uncle-lu/timeClock/README.md

# 电子设计实习-数字钟

基于74LS160实现的数字钟

## 功能

- 1Hz计数
- 时分秒显示
- 快捷校时
- 整点报时

## 组件

- 555组成多谐振荡器
- 74LS160组成分频器
- 74LS160组成60进制计数器
- 74LS160组成24进制计数器
- 报时电路
- 校时电路

## 集成电路器件

- 555
- 74LS160
- 74LC4511
- 74LS00
- 74LS20
- 74LS02
