uncle-lu/timeClock/doc/img/运行图像.png

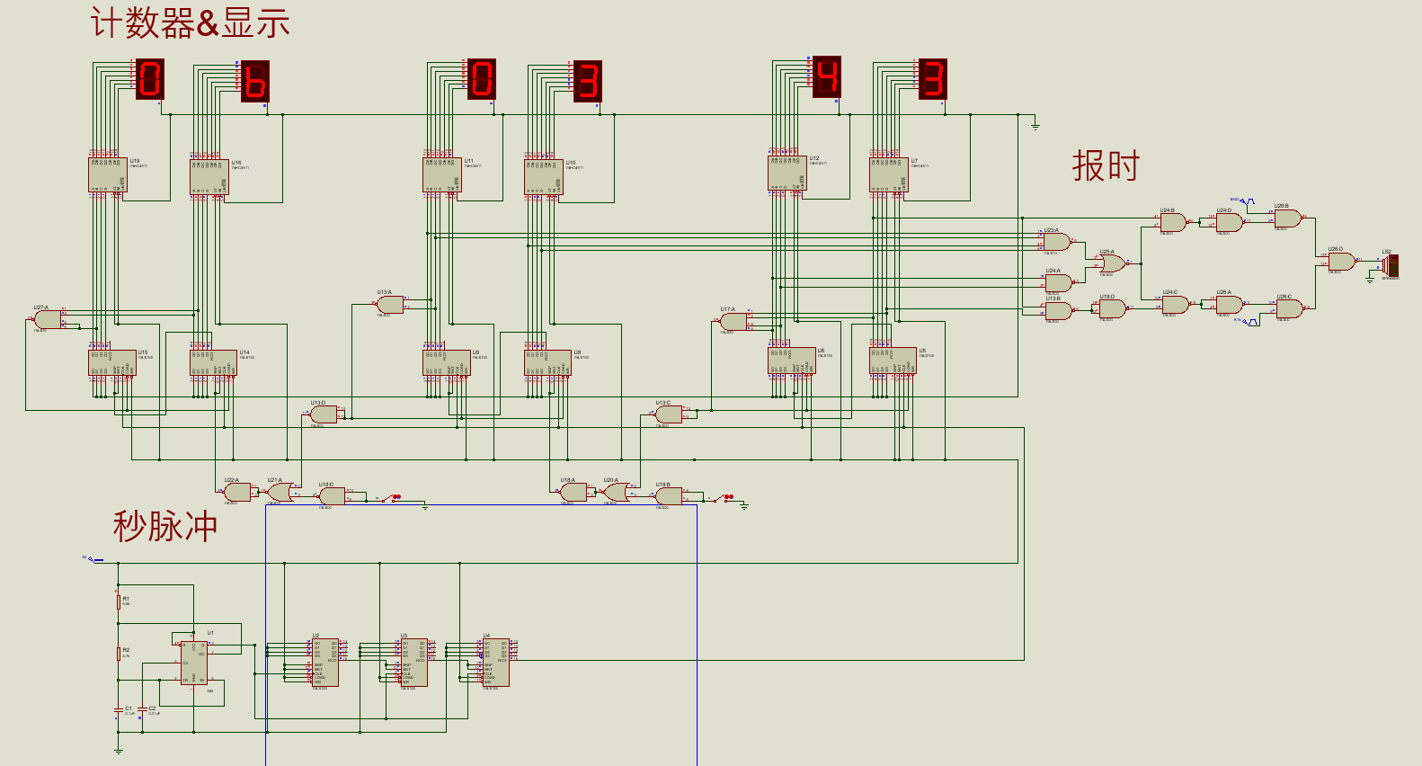
doc/img/运行图像.png
