uncle-lu/timeClock/test/speak.PDF

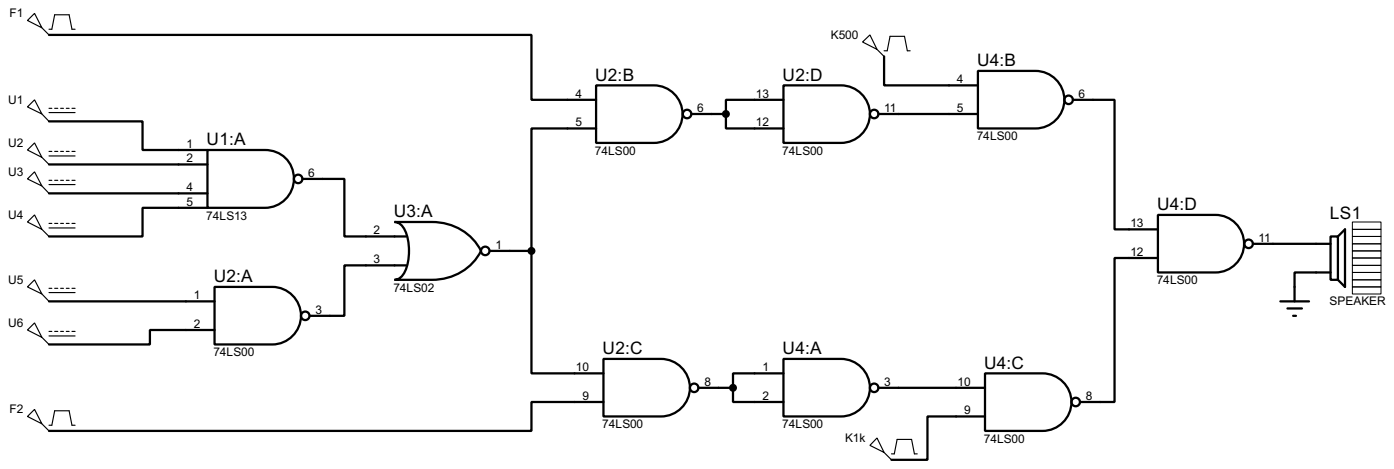
[picture p8: page 1]
