uncle-lu/timeClock/doc/pdf/总电路.PDF

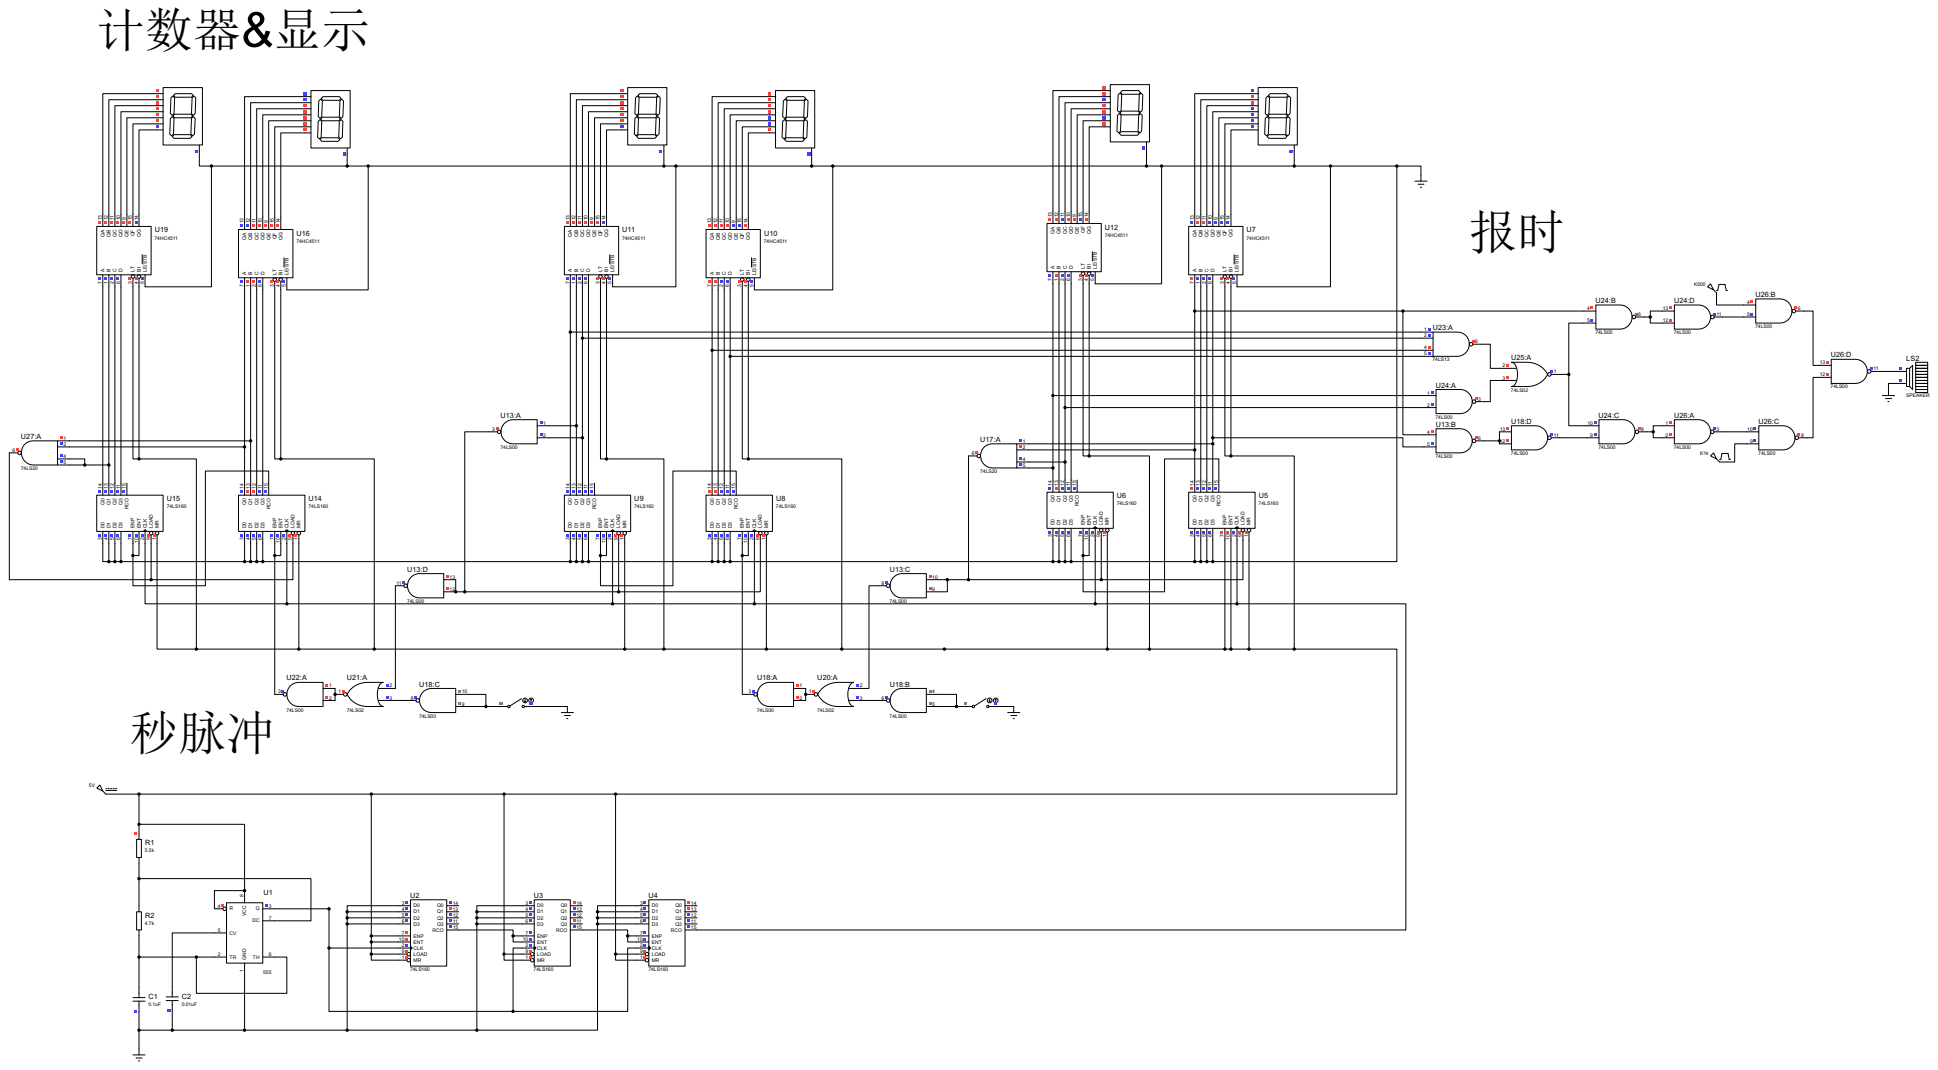
[picture p9: page 1]
