uncle-lu/timeClock/doc/pdf/报时电路.PDF

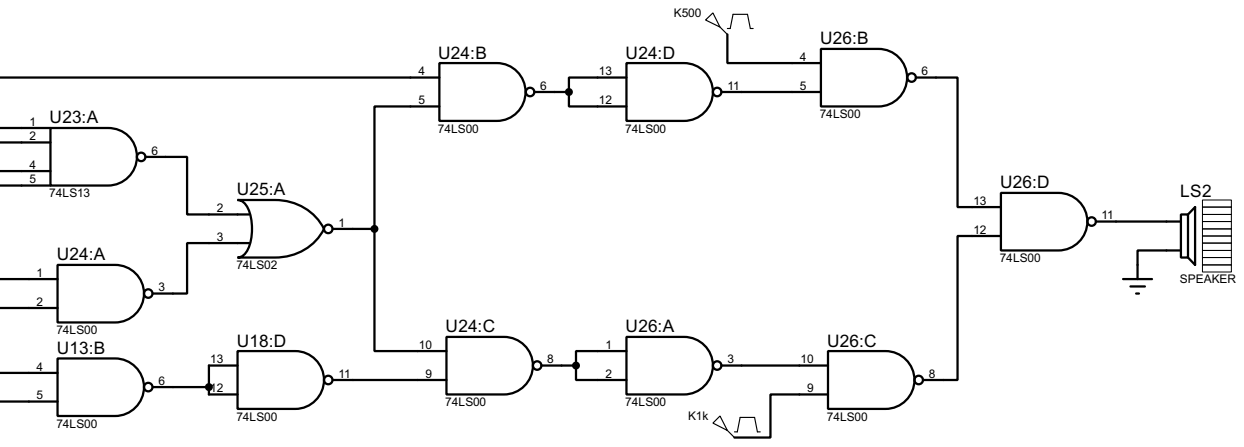
[picture p10: page 1]
