uncle-lu/timeClock/doc/pdf/秒脉冲.PDF

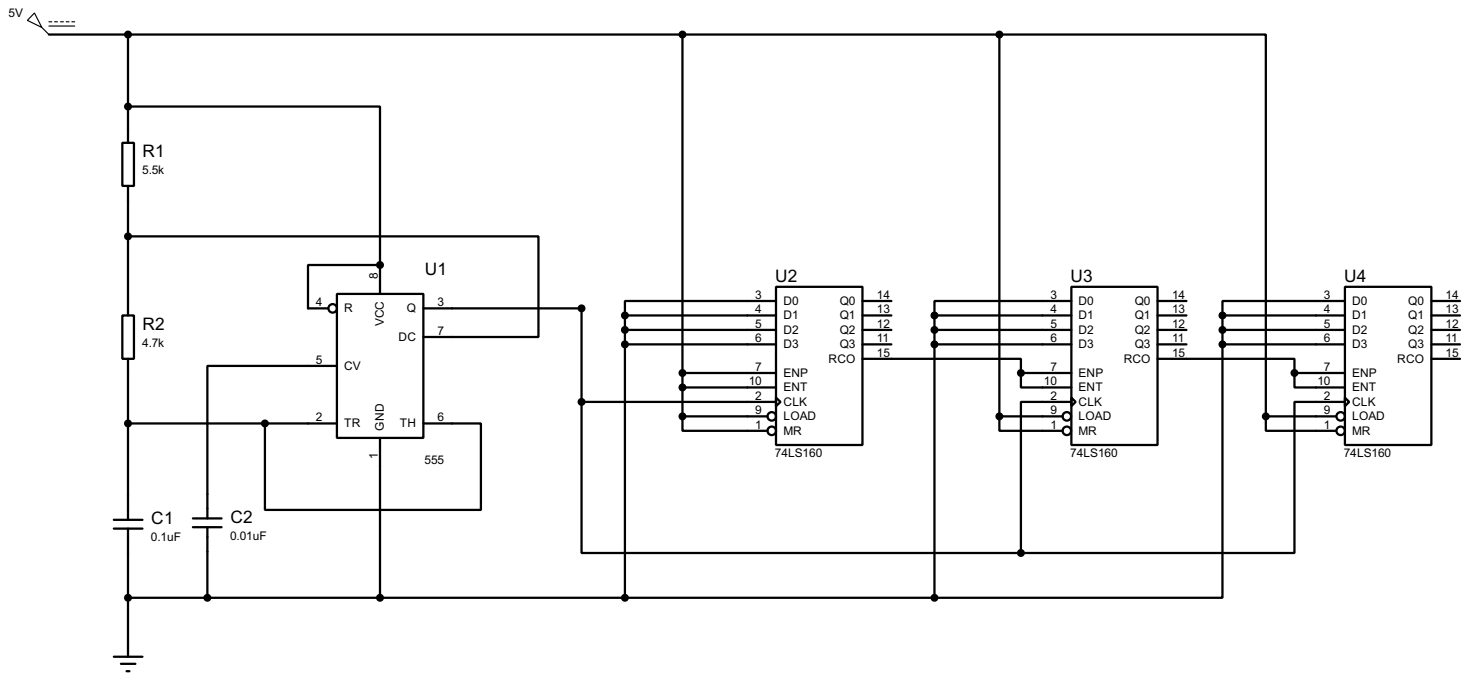
[picture p11: page 1]
