uncle-lu/timeClock/doc/pdf/自动校时电路.PDF

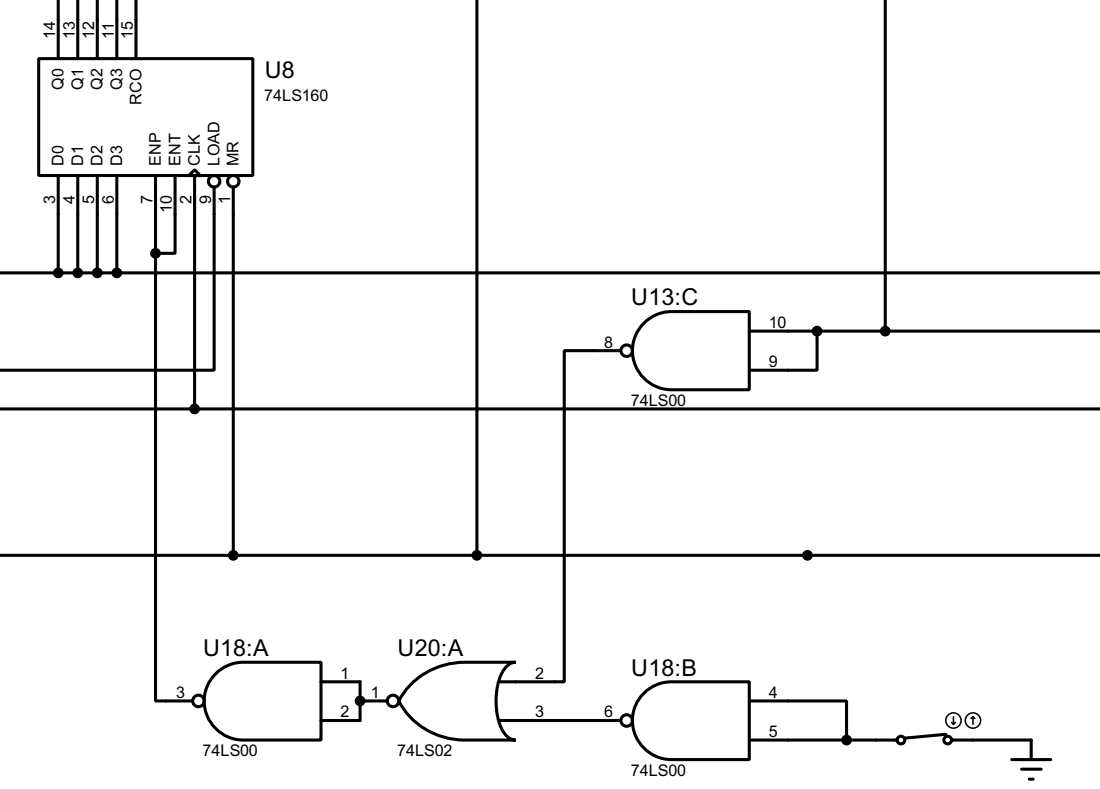
[picture p12: page 1]
