uncle-lu/timeClock/doc/pdf/计数器-24进制.PDF

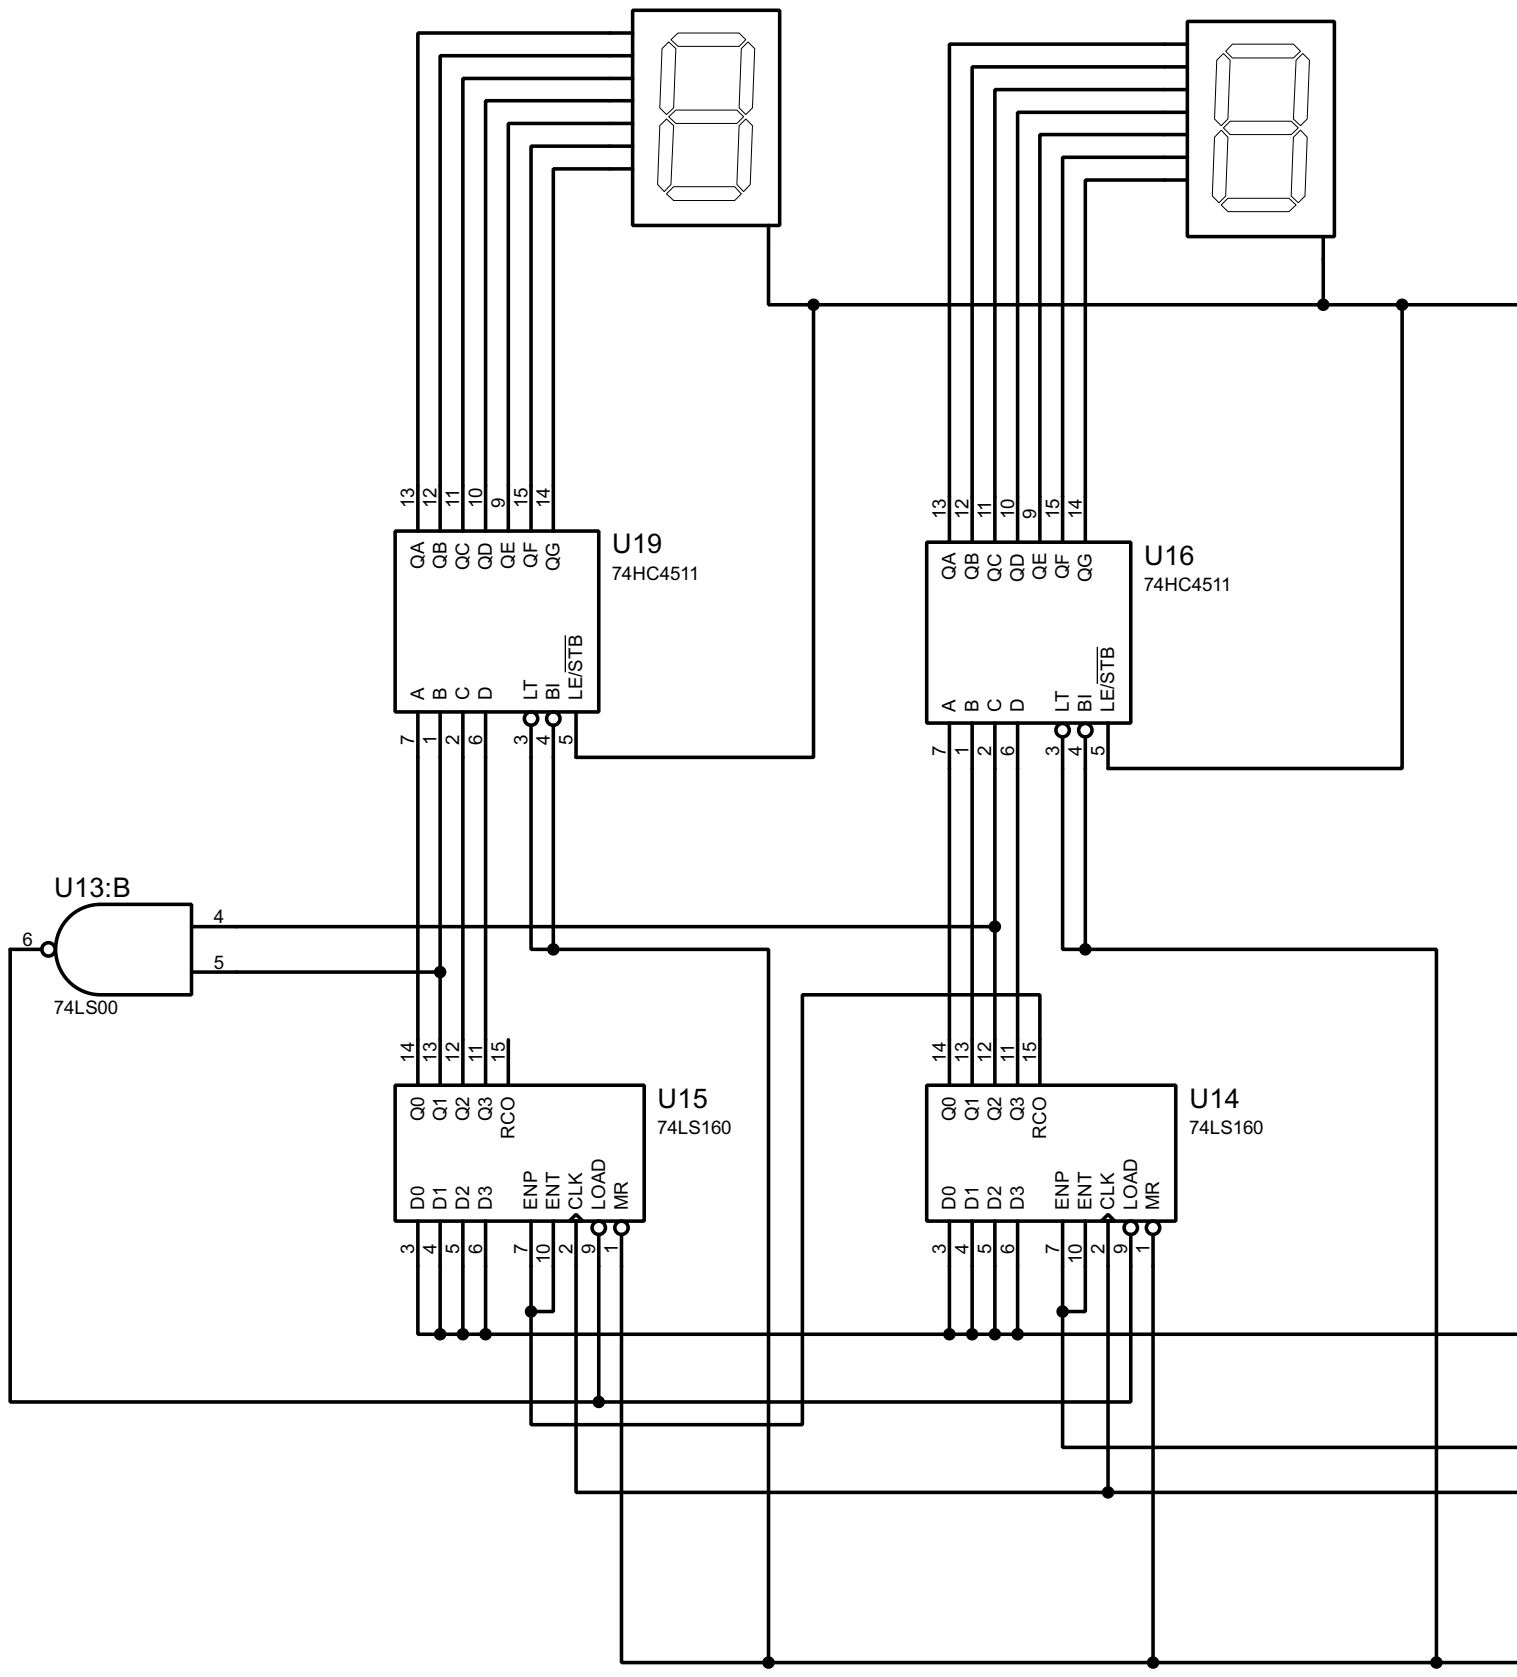
[picture p13: page 1]
