uncle-lu/timeClock/doc/pdf/计数器-60进制.PDF

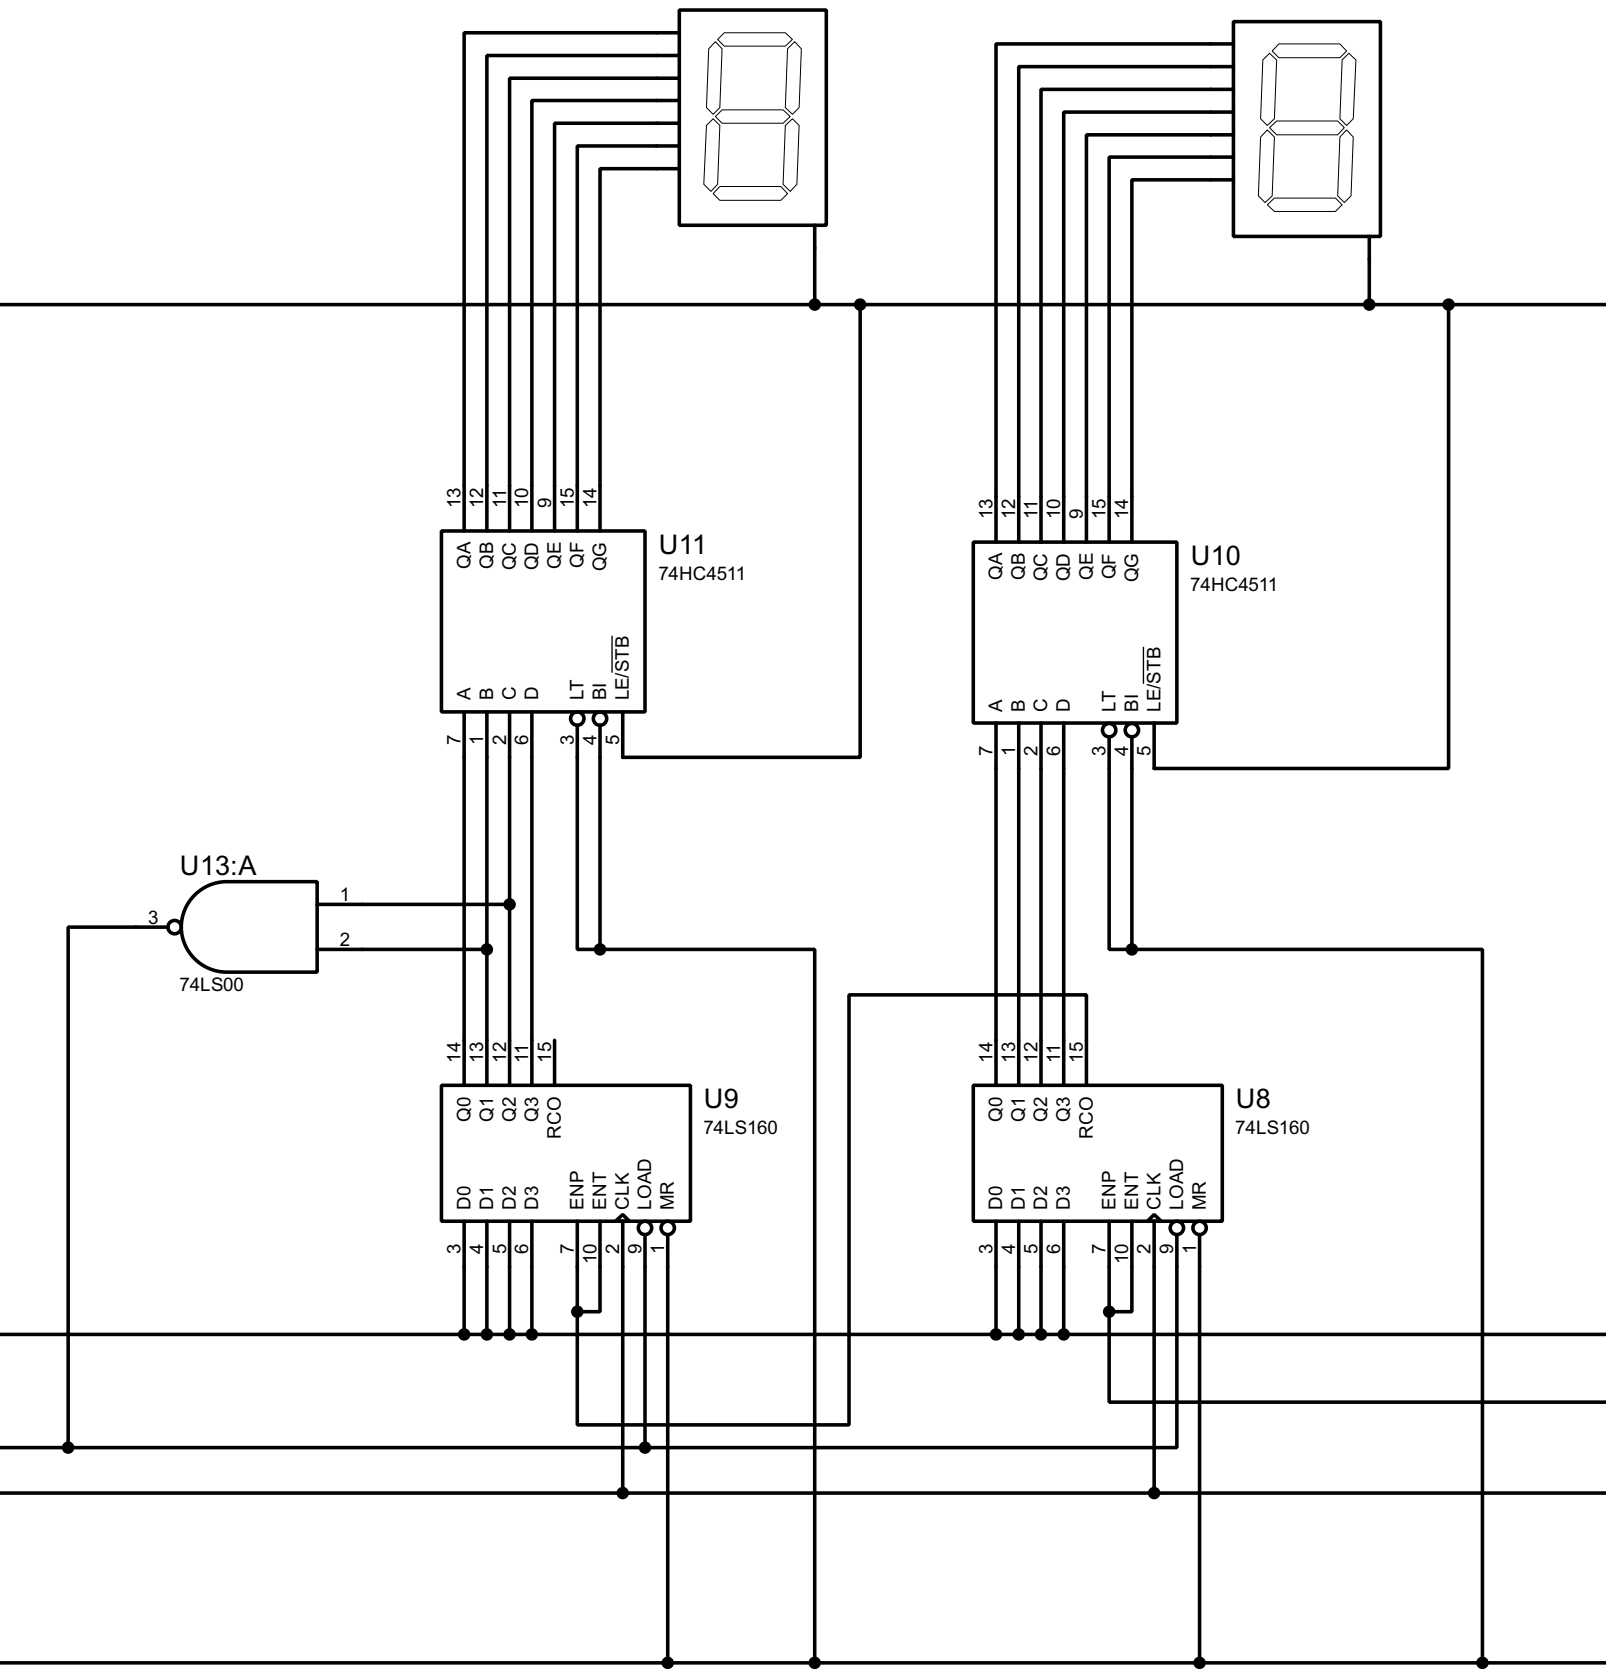
[picture p14: page 1]
