uncle-lu/timeClock/doc/pdf/计数器-全.PDF

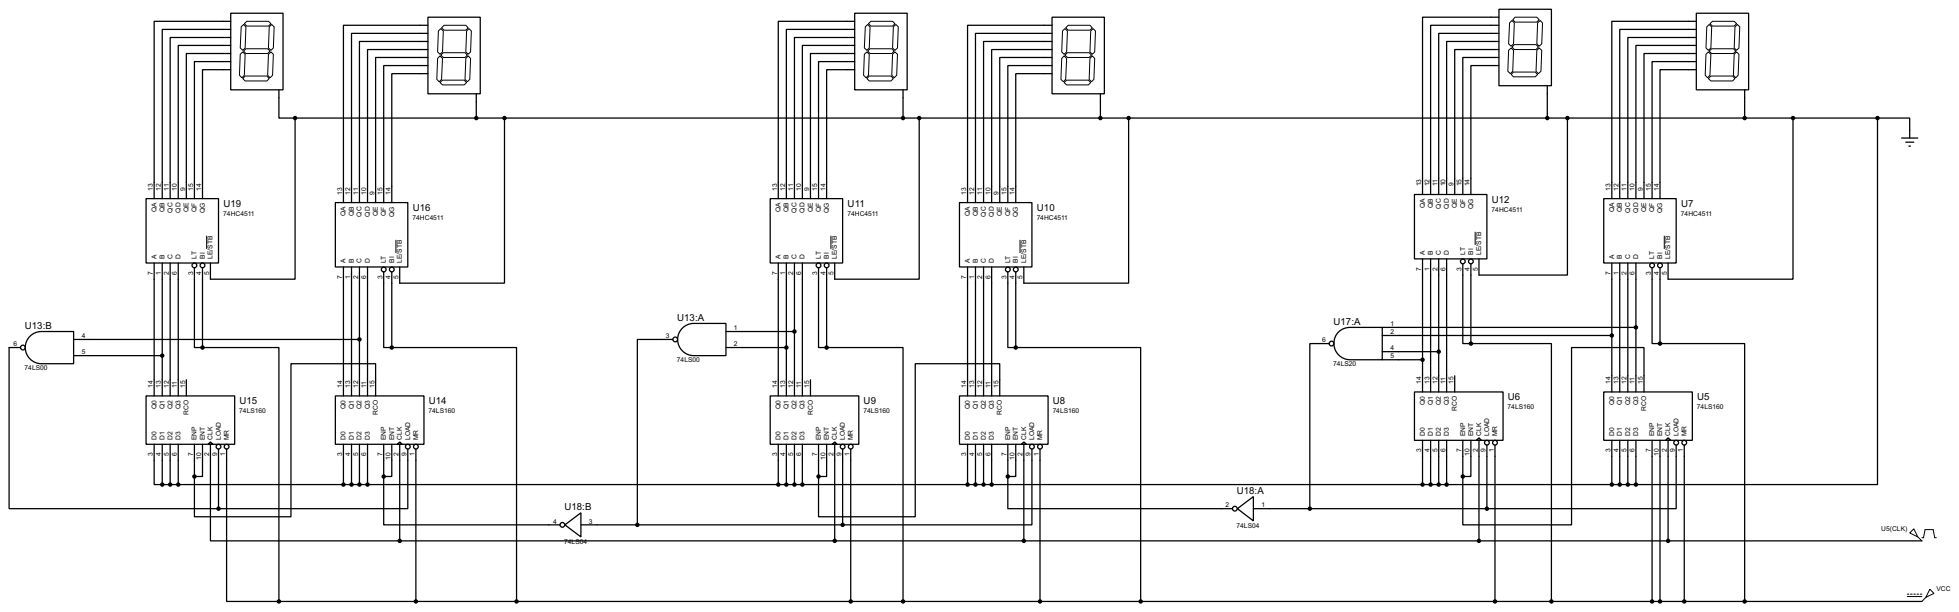
[picture p15: page 1]

D0 3 Q0 14 D1 4 Q1 13 D2 5 Q2 12 D3 6 Q3 11 RCO 15 ENP 7 ENT 10 CLK 2 LOAD 9 MR 1 U5 74LS160 D0 3 Q0 14 D1 4 Q1 13 D2 5 Q2 12 D3 6 Q3 11 RCO 15 ENP 7 ENT 10 CLK 2 LOAD 9 MR 1 U6 74LS160 A 7 B 1 C 2 D 6 LT 3 BI 4 LE/STB 5 QA 13 QB 12 QC 11 QD 10 QE 9 QF 15 QG 14 U7 74HC4511 A 7 B 1 C 2 D 6 LT 3 BI 4 LE/STB 5 QA 13 QB 12 QC 11 QD 10 QE 9 QF 15 QG 14 U12 74HC4511 VCC 2 1 U18:A 74LS04 1245 6 U17:A 74LS20 D0 3 Q0 14 D1 4 Q1 13 D2 5 Q2 12 D3 6 Q3 11 RCO 15 ENP 7 ENT 10 CLK 2 LOAD 9 MR 1 U8 74LS160 D0 3 Q0 14 D1 4 Q1 13 D2 5 Q2 12 D3 6 Q3 11 RCO 15 ENP 7 ENT 10 CLK 2 LOAD 9 MR 1 U9 74LS160 A 7 B 1 C 2 D 6 LT 3 BI 4 LE/STB 5 QA 13 QB 12 QC 11 QD 10 QE 9 QF 15 QG 14 U10 74HC4511 A 7 B 1 C 2 D 6 LT 3 BI 4 LE/STB 5 QA 13 QB 12 QC 11 QD 10 QE 9 QF 15 QG 14 U11 74HC4511 D0 3 Q0 14 D1 4 Q1 13 D2 5 Q2 12 D3 6 Q3 11 RCO 15 ENP 7 ENT 10 CLK 2 LOAD 9 MR 1 U14 74LS160 D0 3 Q0 14 D1 4 Q1 13 D2 5 Q2 12 D3 6 Q3 11 RCO 15 ENP 7 ENT 10 CLK 2 LOAD 9 MR 1 U15 74LS160 A 7 B 1 C 2 D 6 LT 3 BI 4 LE/STB 5 QA 13 QB 12 QC 11 QD 10 QE 9 QF 15 QG 14 U16 74HC4511 A 7 B 1 C 2 D 6 LT 3 BI 4 LE/STB 5 QA 13 QB 12 QC 11 QD 10 QE 9 QF 15 QG 14 U19 74HC4511 4 3 U18:B 74LS04 12 3 U13:A 74LS00 U5(CLK) 45 6 U13:B 74LS00
