uncle-lu/timeClock/(list of files, drawings)

Other design files:
source/timeClock.pdsprj
test/speak.pdsprj
