uncle-lu/timeClock/(commit log)

2021-11-05 修改目录
2021-11-05 增加README、修改目录
    [timeClock.pdsprj]
2021-11-05 删除备份文件
